bvirk/heatskirt/ConsoleShellDeploy/README.md

ConsoleShellDeploy is a prebuild step (.vscode/arduino.json->{... "prebuild": "consoleShellDeploy"})
